cashmoneyisaac/mspm0-microcontroller-pcb/manufacturing/assembly/TI-MSPM0-BOM.csv

Comment | Designator | Footprint | LCSC Part # | Manufacturer | MPN | Quantity
10uF 25V X5R 10% | C1,C10,C16 | 1206 | C9807 | Samsung Electro-Mechanics | CL31A106KAHNNNE | 3
470nF 16V X7R 10% | C2,C7,C8,C12,C13,C14 | 0603 | C105526 | Samsung Electro-Mechanics | CL10B474KO8NNNC | 6
1uF 25V X7R 10%; VREF decoupling | C3 | 0603 | C29936 | Samsung Electro-Mechanics | CL10B105KA8NNNC | 1
10nF 50V X7R 10% | C4,C11 | 0603 | C1589 | Samsung Electro-Mechanics | CL10B103KB8NNNC | 2
15pF 50V C0G 5% | C5,C6 | 0603 | C91703 | FH (Guangdong Fenghua Advanced Tech) | 0603CG150J500NT | 2
4.7uF 25V X7R 10% | C9 | 1206 | C5348850 | Kyocera AVX | 12063C475K4T2A | 1
100nF 50V X7R 10% | C15 | 0603 | C1591 | Samsung Electro-Mechanics | CL10B104KB8NNNC | 1
0 ohm jumper 100mW | R1,R4 | 0603 | C21189 | UNI-ROYAL | 0603WAF0000T5E | 2
47kohm 1% 100mW | R2 | 0603 | C25819 | UNI-ROYAL | 0603WAF4702T5E | 1
100kohm 0.1% 25ppm/C 100mW; ROSC precision resistor | R3 | 0603 | C855559 | YAGEO | AT0603BRD07100KL | 1
5.1kohm 1% 100mW | R5,R6,R7,R8 | 0603 | C23186 | UNI-ROYAL | 0603WAF5101T5E | 4
2.2kohm 1% 100mW | R9 | 0603 | C4190 | UNI-ROYAL | 0603WAF2201T5E | 1
USB Type-C USB2.0; 0.60mm shell stakes | J1 | USB4105 top mount | C3025063 | GCT | USB4105-GF-A-060 | 1
MSPM0G3507 MCU; 48-pin LQFP 7x7mm | U1 | LQFP-48_7x7mm_P0.5mm | C22362630 | Texas Instruments | MSPM0G3507SPTR | 1
USB dual data-line ESD protection | U2 | SOT-23-6 | C7519 | STMicroelectronics | USBLC6-2SC6 | 1
3.3V 500mA LDO; MaxLinear original | U3 | SOT-23-5 | C9055 | MaxLinear | SPX3819M5-L-3-3/TR | 1
USB UART bridge | U4 | MSOP-10 | C99652 | WCH | CH340E | 1
3-axis accelerometer; original 14-pin LIS2DH | U5 | LGA-14_2x2mm_P0.35mm | C155670 | STMicroelectronics | LIS2DHTR | 1
8MHz passive crystal; 12pF CL; 20ppm tolerance; 30ppm stability; 400ohm max ESR; 100uW drive | X1 | SMD3225-4P |  | ECS Inc. | ECS-80-12-33-JGN-TR3 | 1
