cashmoneyisaac/mspm0-microcontroller-pcb/docs/Reviewed-schematic.pdf

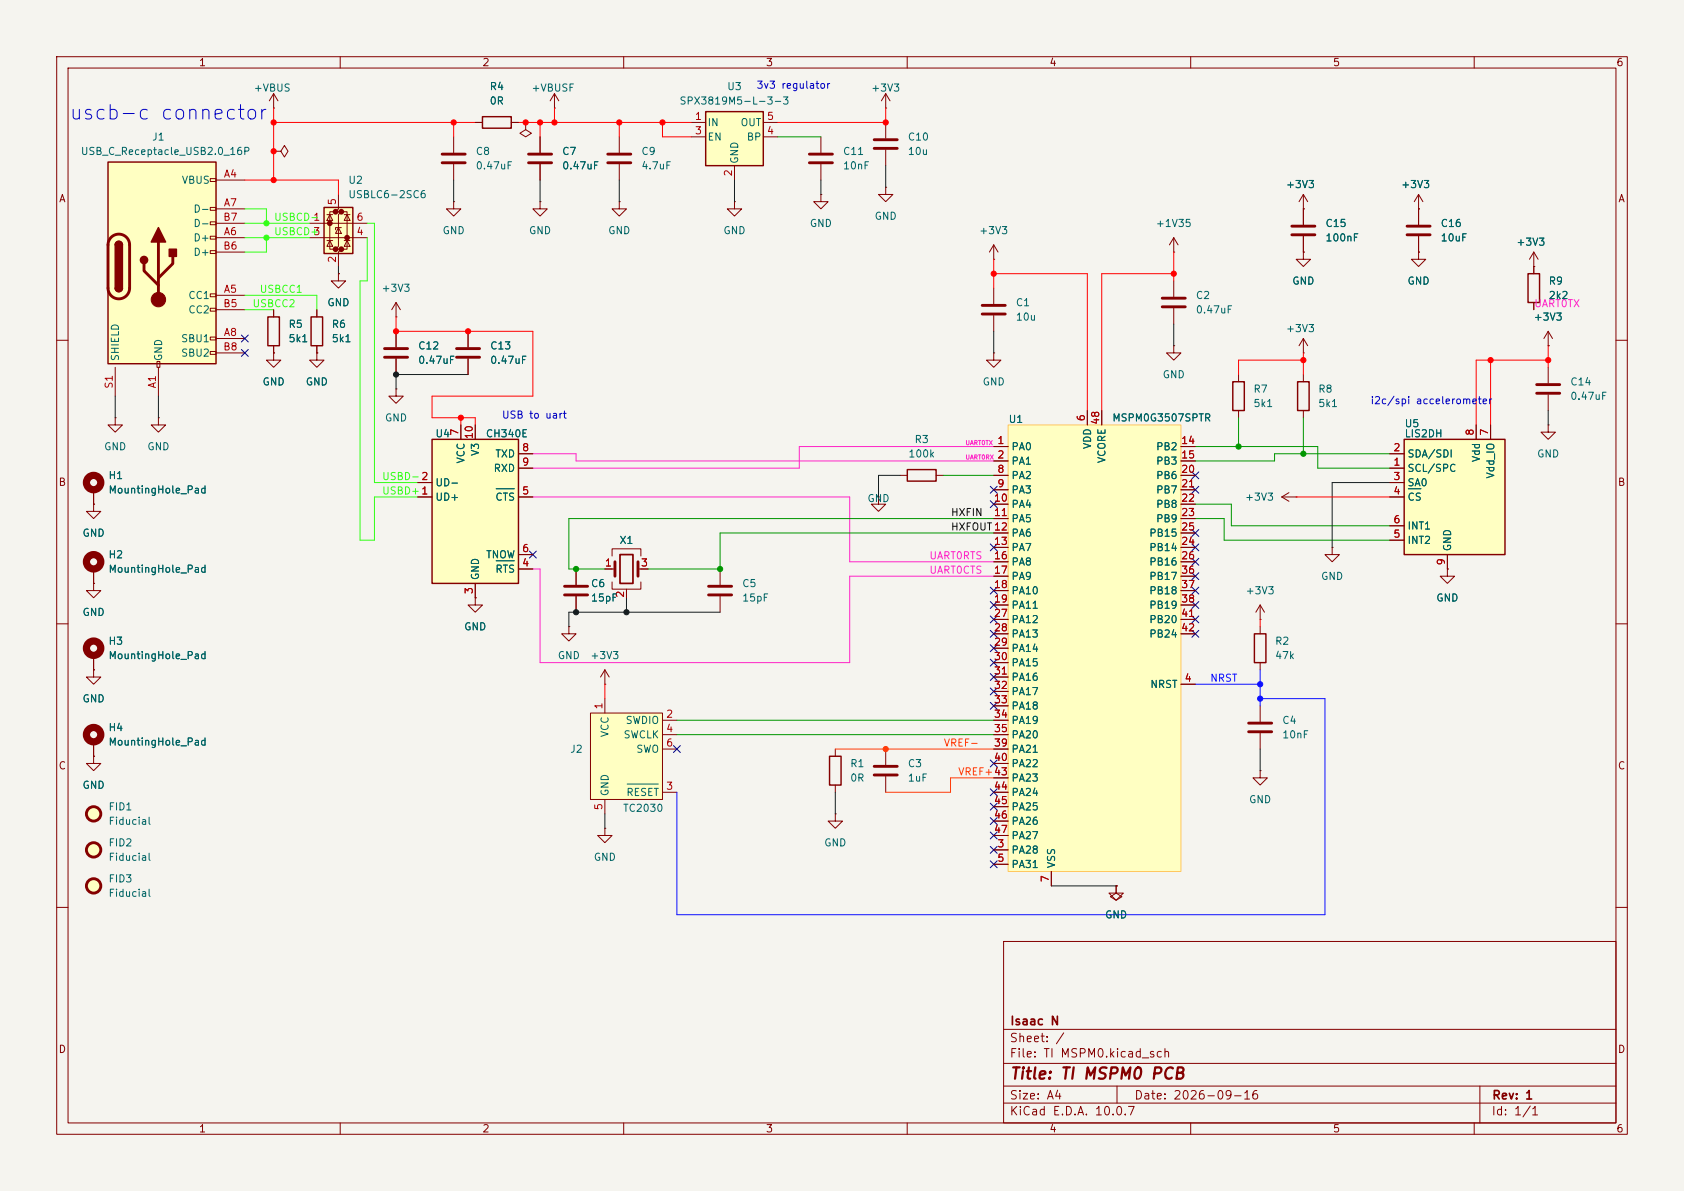
[picture p1: page 1]

Size: A4 | Rev: 1
KiCad E.D.A. 10.0.7 | Id: 1/1
