cashmoneyisaac/mspm0-microcontroller-pcb/TI MSPM0.kicad_pcb

## KiCad design TI MSPM0.kicad_pcb (2026-10-25)

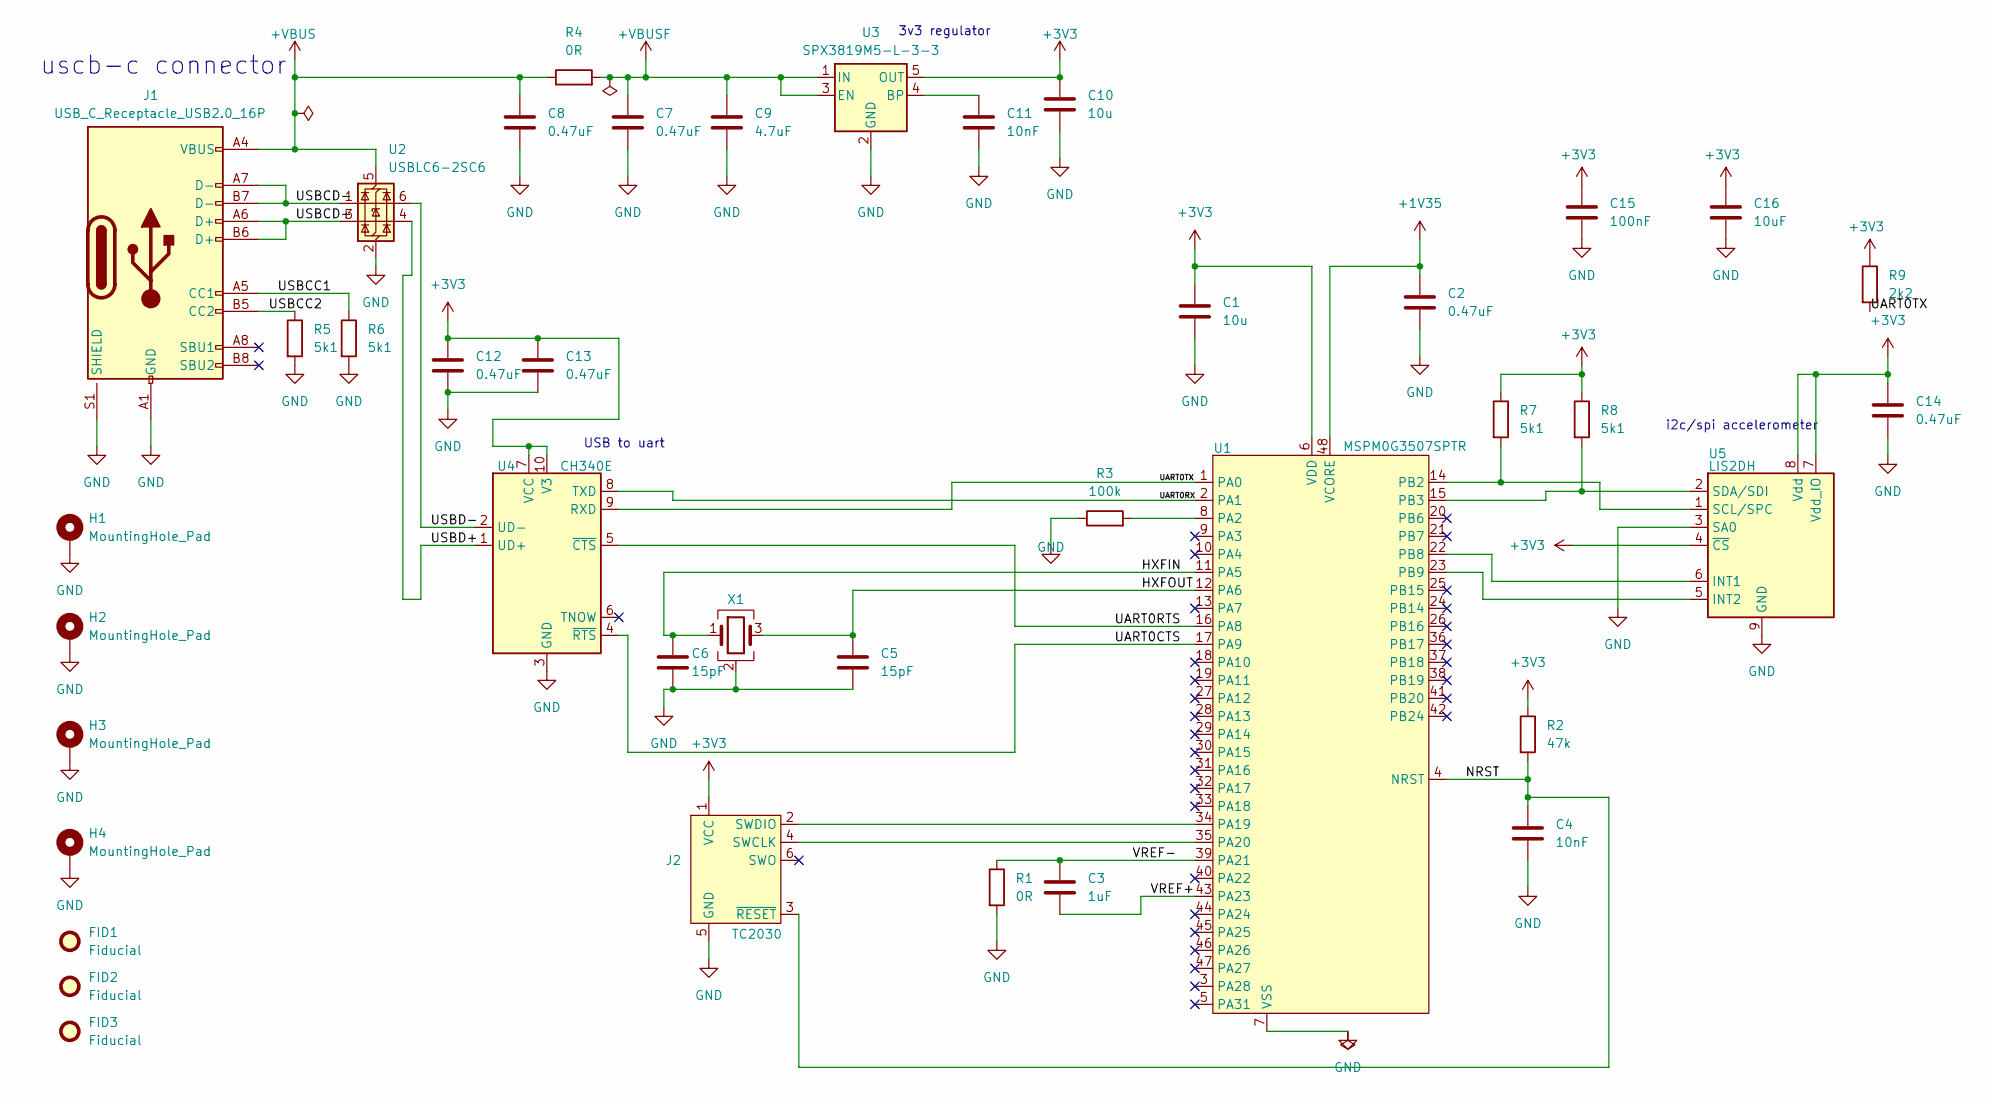
[picture p2: schematic TI MSPM0.kicad_sch, TI MSPM0 PCB]

Parts:
C1, C10: 10u; C_1206_3216Metric; Tolerance ±10%; Voltage 25V; MPN CL31A106KAHNNN
C2, C7, C8, C12, C13, C14: 0.47uF; C_0603_1608Metric; Tolerance ±10%; Digikey PN 490-3295-1-ND
C3: 1uF; C_0603_1608Metric; Tolerance ±10%
C4, C11: 10nF; C_0603_1608Metric; Tolerance ±10%
C5, C6: 15pF; C_0603_1608Metric; Tolerance ±10%
C9: 4.7uF; C_1206_3216Metric; Tolerance ±10%; Voltage 25V
C15: 100nF; C_0603_1608Metric
C16: 10uF; C_1206_3216Metric
FID1, FID2, FID3: Fiducial; Fiducial_1mm_Mask2mm
H1, H2, H3, H4: MountingHole_Pad; MountingHole_2.2mm_M2_Pad
J1: USB_C_Receptacle_USB2.0_16P; USB_C_Receptacle_GCT_USB4105-xx-A_16P_TopMnt_Horizontal
J2: TC2030; Tag-Connect_TC2030-IDC-FP_2x03_P1.27mm_Vertical
R1, R4: 0R; R_0603_1608Metric
R2: 47k; R_0603_1608Metric
R3: 100k; R_0603_1608Metric; PartNumber AT0603BRD07100KL; JLCPCBPart# C855559
R5, R6, R7, R8: 5k1; R_0603_1608Metric
R9: 2k2; R_0603_1608Metric
U1: MSPM0G3507SPTR; LQFP-48_7x7mm_P0.5mm
U2: USBLC6-2SC6; SOT-23-6
U3: SPX3819M5-L-3-3; SOT-23-5
U4: CH340E; MSOP-10_3x3mm_P0.5mm
U5: LIS2DH; LGA-14_2x2mm_P0.35mm_LayoutBorder3x4y
X1: ECS-80-12-33-JGN-TR3; Crystal_SMD_3225-4Pin_3.2x2.5mm

Connections:
+1V35: C2.1, U1.48 (VCORE)
+3V3: C1.2, C10.2, C12.1, C13.1, C14.1, C15.1, C16.1, J2.1 (VCC), R2.1, R7.1, R8.1, R9.1, U1.6 (VDD), U3.5 (OUT), U4.7 (VCC), U4.10 (V3), U5.4 (~CS), U5.7 (Vdd_IO), U5.8 (Vdd)
+VBUS: C8.1, J1.A4 (VBUS), J1.A9 (VBUS), J1.B4 (VBUS), J1.B9 (VBUS), R4.1, U2.5 (VBUS)
+VBUSF: C7.1, C9.2, R4.2, U3.1 (IN), U3.3 (EN)
/HXFIN: C6.1, U1.11 (PA5), X1.1
/HXFOUT: C5.1, U1.12 (PA6), X1.3
/NRST: C4.1, J2.3 (~RESET), R2.2, U1.4 (NRST)
/UART0CTS: U1.17 (PA9), U4.4 (~RTS)
/UART0RTS: U1.16 (PA8), U4.5 (~CTS)
/UART0RX: U1.2 (PA1), U4.8 (TXD)
/UART0TX: R9.2, U1.1 (PA0), U4.9 (RXD)
/USBCC1: J1.A5 (CC1), R6.1
/USBCC2: J1.B5 (CC2), R5.1
/USBCD+: J1.A6 (D+), J1.B6 (D+), U2.3 (I/O2)
/USBCD-: J1.A7 (D-), J1.B7 (D-), U2.1 (I/O1)
/USBD+: U2.4 (I/O2), U4.1 (UD+)
/USBD-: U2.6 (I/O1), U4.2 (UD-)
/VREF+: C3.2, U1.43 (PA23)
/VREF-: C3.1, R1.1, U1.39 (PA21)
GND: C1.1, C2.2, C4.2, C5.2, C6.2, C7.2, C8.2, C9.1, C10.1, C11.2, C12.2, C13.2, C14.2, C15.2, C16.2, H1.1 (1_1), H2.1 (1_1), H3.1 (1_1), H4.1 (1_1), J1.A1 (GND), J1.A12 (GND), J1.B1 (GND), J1.B12 (GND), J1.S1 (SHIELD), J2.5 (GND), R1.2, R3.1, R5.2, R6.2, U1.7 (VSS), U2.2 (GND), U3.2 (GND), U4.3 (GND), U5.3 (SA0), U5.9 (GND), U5.10 (GND), U5.11 (GND), U5.12 (GND), U5.13 (GND), U5.14 (GND), X1.2 (G), X1.4 (G)
unnamed: J2.4 (SWCLK), U1.35 (PA20)
unnamed: J2.2 (SWDIO), U1.34 (PA19)
unnamed: R3.2, U1.8 (PA2)
unnamed: R7.2, U1.14 (PB2), U5.1 (SCL/SPC)
unnamed: R8.2, U1.15 (PB3), U5.2 (SDA/SDI)
unnamed: U1.22 (PB8), U5.6 (INT1)
unnamed: U1.23 (PB9), U5.5 (INT2)
unnamed: C11.1, U3.4 (BP)

Notes on the sheet:
i2c/spi accelerometer
uscb-c connector
USB to uart
3v3 regulator

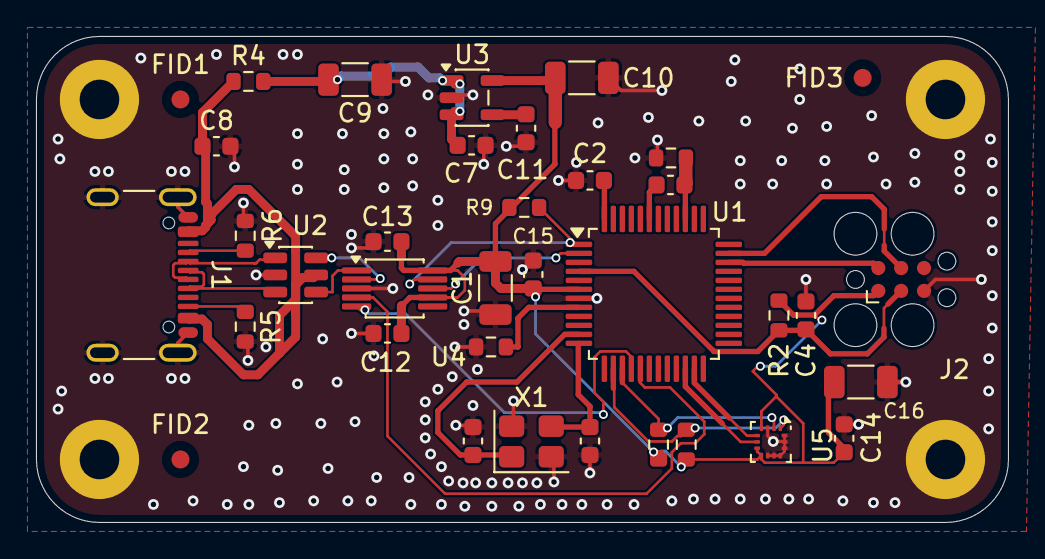
[picture p3: board TI MSPM0.kicad_pcb from above]

Board: 2 copper layers, 54.0 x 27.0 mm, 40 parts (0 on the bottom side), 28 nets.
