cashmoneyisaac/mspm0-microcontroller-pcb/(commit log)

2026-10-25 Add MSPM0 PCB design and project overview
    [TI MSPM0.kicad_pcb, TI MSPM0.kicad_sch]
2026-10-25 Add schematic, board previews and design review
2026-10-25 Add fabrication and assembly export packages
2026-10-25 Add BOM, component placement and assembly notes
    [TI-MSPM0-BOM.csv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]
2026-10-25 Add individual Gerber layers and drill outputs
    [TI MSPM0-B_Cu.gbl, TI MSPM0-B_Mask.gbs, TI MSPM0-B_Paste.gbp, TI MSPM0-B_Silkscreen.gbo, TI MSPM0-Edge_Cuts.gm1, TI MSPM0-F_Cu.gtl, TI MSPM0-F_Mask.gts, TI MSPM0-F_Paste.gtp]
